AngeloDuenas/Micromouse/Micromouse v2/team3_BOM_micromouse_202526_7F5.xlsx

Price | Qty | Value | Datasheet | Digikey | Reference | Description | Tag
0.10 | 1 | 440054-2 | https://www.te.com/usa-en/product-440054-2.datasheet.pdf | https://www.digikey.com/en/products/detail/te-connectivity-amp-connectors/440054-2/2077939 | J1 | Connector Header Through Hole 2 position 0.079" (2.00mm) | 2
3.56 | 4 | INL-5AMIR15 | https://www.inolux-corp.com/datasheet/IR/Emitter/5mm%20Lamp/INL-5AMIR15_V1.0.pdf | https://www.digikey.com/en/products/detail/inolux/INL-5AMIR15/10384755 | LED1,LED2,LED3,LED4 | Infrared (IR) Emitter 880nm 1.3V 100mA 7.8mW/sr @ 20mA 15° Radial | 2
1.72 | 4 | BS170 | https://www.onsemi.com/pub/Collateral/BS170-D.PDF | https://www.digikey.com/en/products/detail/onsemi/BS170/244280 | Q1,Q2,Q3,Q4 | N-Channel 60 V 500mA (Ta) 830mW (Ta) Through Hole TO-92-3 | 2
3.20 | 4 | SFH 313 FA-3/4 | https://look.ams-osram.com/m/5f84917e436bcd12/original/SFH-313-FA.pdf | https://www.digikey.com/en/products/detail/ams-osram-usa-inc/SFH-313-FA-3-4/1630112 | Q5,Q6,Q7,Q8 | Phototransistors 870nm Top View Radial | 2
0.72 | 1 | EG1218 | https://configured-product-images.s3.amazonaws.com/Datasheets/EG.pdf | https://www.digikey.com/en/products/detail/e-switch/EG1218/101726 | SW1 | Slide Switch SPDT Through Hole | 2
0.57 | 1 | LD1117V33 | https://www.st.com/content/ccc/resource/technical/document/datasheet/99/3b/7d/91/91/51/4b/be/CD00000544.pdf/files/CD00000544.pdf/jcr:content/translations/en.C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 | https://www.digikey.com/en/products/detail/stmicroelectronics/LD1117V33/586012 | U1 | Linear Voltage Regulator IC Positive Fixed 1 Output 800mA TO-220 | 2
8.86 | 1 | L293D | https://www.st.com/content/ccc/resource/technical/document/datasheet/04/ac/22/f9/20/5d/43/a1/CD00000059.pdf/files/CD00000059.pdf/jcr:content/translations/en.C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 | https://www.digikey.com/en/products/detail/stmicroelectronics/L293D/634700 | U2 | Bipolar Motor Driver Parallel 16-PowerDIP | 2
1.74 | 2 | BM06B-SRSS-TBT | https://www.jst-mfg.com/product/pdf/eng/eSR_SZ.pdf | https://www.digikey.com/en/products/detail/jst-sales-america-inc/bm06b-srss-tbt/1785724 | J3,J4 | Connector Header Surface Mount 6 position 0.039" (1.00mm) | 0
7.18 | 2 | PinSocket_2x19_P2.54mm_Vertical | https://www.pololu.com/product/3676/specs | https://www.pololu.com/product/3676 | J5,J6 | Stackable 0.100″ Female Header for TI-RSLK MAX: 2x19-Pin, Straight | 0
9.50 | 2 | PinSocket_2x20_P2.54mm_Vertical | https://www.pololu.com/product/2748/specs | https://www.pololu.com/product/2748 | ~ | This stackable 40-pin female header features two rows of 20 pins spaced with a 0.1″ (2.54 mm) pitch. The extended pins allow multiple units to be stacked as popularized on Arduino shields. The 2×20 size is notably used on the Raspberry Pi Models A+ and B+ as well as the Raspberry Pi 2 Model B. | 0
0.79 | 1 | PinHeader_1x04_P2.54mm_Vertical_SMD_Pin1Left | https://www.pololu.com/product/1014/specs | https://www.pololu.com/product/1014 | J7 | 0.100" (2.54 mm) Female Header: 1x4-Pin, Straight | 0
59.90 | 2 | 30:1 Micro Metal Gearmotor MP 6V with 12 CPR Encoder, Back Connector | https://www.pololu.com/file/0J1487/pololu-micro-metal-gearmotors-rev-6-1.pdf | https://www.pololu.com/product/5132 | ~ | MP 6V: medium-power 6V with precious metal brushes, 9.86:1 with brass plates , 6 V , 720 RPM, 70 mA | 3
2.95 | 1 | Pololu Micro Metal Gearmotor Bracket Pair – White | https://www.pololu.com/product/1086/specs | https://www.pololu.com/product/1086 | ~ | These plastic mounting brackets allow you to easily and securely mount the ubiquitous 10 mm × 12 mm × 26 mm metal gearhead motors first popularized by Sanyo’s 12GN series (e.g. NA1S…NA3S), such as our micro metal gearmotors. We offer these brackets in black plastic and white plastic, and we offer an extended version that might work better for particular applications. | 3
4.45 | 1 | Pololu Wheel 32×7mm Pair - White | https://www.pololu.com/product/1088/specs | https://www.pololu.com/product/1088/ | ~ | These white plastic wheels have silicone tires and measure 32 mm (1.26″) in diameter. They press-fit onto the 3mm D shafts on many of our motors, including our micro metal gearmotors and our mini plastic gearmotors, to make a nice drive solution for small robots. They are sold in pairs. | 3
7.22 | 2 | JST SH-Style Cable, 6-Pin, Female-Female, 16cm | https://www.pololu.com/product/5544/specs | https://www.pololu.com/product/5544 | ~ | This 6-conductor, 16 cm (6.3″) cable has 28 AWG wires and 6-pin female JST SH-type connectors (1mm pitch) on both ends. | 3
13.82 | 1 | NUCLEO-F411RE | https://www.st.com/content/ccc/resource/technical/document/data_brief/c8/3c/30/f7/d6/08/4a/26/DM00105918.pdf/files/DM00105918.pdf/jcr:content/translations/en.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 | https://www.digikey.com/en/products/detail/stmicroelectronics/NUCLEO-F411RE/4866485 | ~ | STM32F411RE Nucleo-64 STM32F4 ARM® Cortex®-M4 MCU 32-Bit Embedded Evaluation Board | 1
0.00 | 4 | 47KΩ | ~ | ~ | R2,R6,R9,R12 | 47KΩ±1% 1/4W Metal Film Resistor Axial | 0
0.00 | 4 | 51Ω | ~ | ~ | R3,R7,R10,R13 | 51Ω±1% 1/4W Metal Film Resistor Axial | 0
0.00 | 4 | 100Ω | ~ | ~ | R1,R5,R8,R11 | 100Ω±1% 1/4W Metal Film Resistor Axial | 0
0.00 | 4 | 1.8KΩ | ~ | ~ | R4,R14,R15,R16 | 1.8KΩ±1% 1/4W Metal Film Resistor Axial | 0
0.00 | 3 | 0.1uF | ~ | ~ | C1,C5,C8 | 0.1µF ±10% 50V Multilayer Ceramic Capacitor Radial | 0
0.00 | 1 | 1uF | ~ | ~ | C9 | 1.0µF ±10% 50V Multilayer Ceramic Capacitor Radial | 0
0.00 | 3 | 4.7uF | ~ | ~ | C4,C6,C7 | 4.7µF ±10% 25V Multilayer Ceramic Capacitor Radial | 0
0.00 | 2 | 10uF | ~ | ~ | C2,C3 | 10µF ±10% 25V Multilayer Ceramic Capacitor Radial | 0
0.00 | 1 | Battery | ~ | ~ | ~ | ~ | 1
126.28 | 56 | Budget | ~ | ~ | ~ | Team 3 Micromouse 2026 Budget | -1
