AngeloDuenas/Micromouse/Micromouse v2/imports/CF18JT680R.STEP

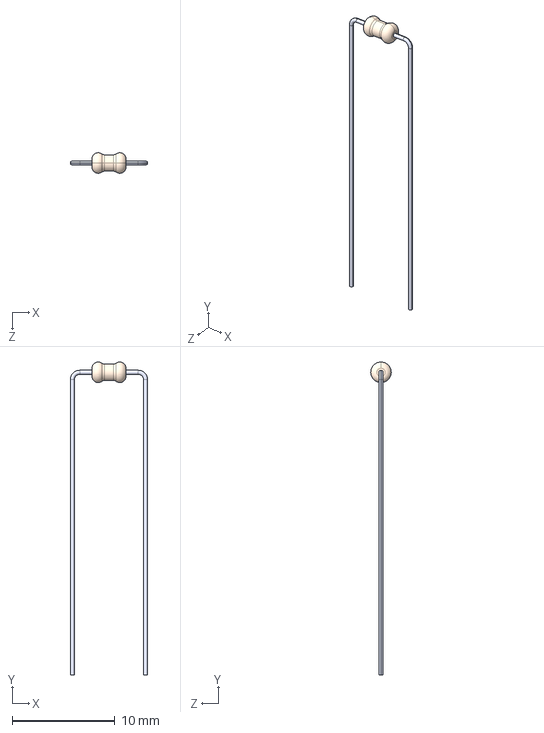
[picture p1: CAD file, 2026-10-30]
Micromouse v2/imports/CF18JT680R.STEP
7.52 x 30.4 x 2.00 mm
