AngeloDuenas/Micromouse/Micromouse v2/imports/ul_BM06B-SRSS-TB-LF-SN-/BM06B-SRSS-TBT--3DModel-STEP-56544.STEP

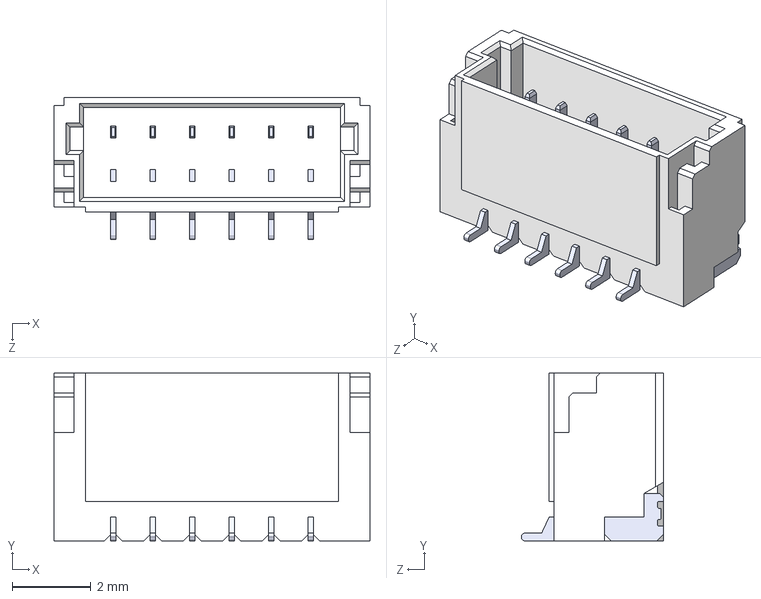
[picture p2: CAD file, 2026-10-30]
Micromouse v2/imports/ul_BM06B-SRSS-TB-LF-SN-/BM06B-SRSS-TBT--3DModel-STEP-56544.STEP
8.00 x 4.25 x 3.60 mm
