AngeloDuenas/Micromouse/Micromouse v2/imports/ul_INL-5AMIR15/Download_STP_WL-TIRW-5mm+%28rev1%29.stp

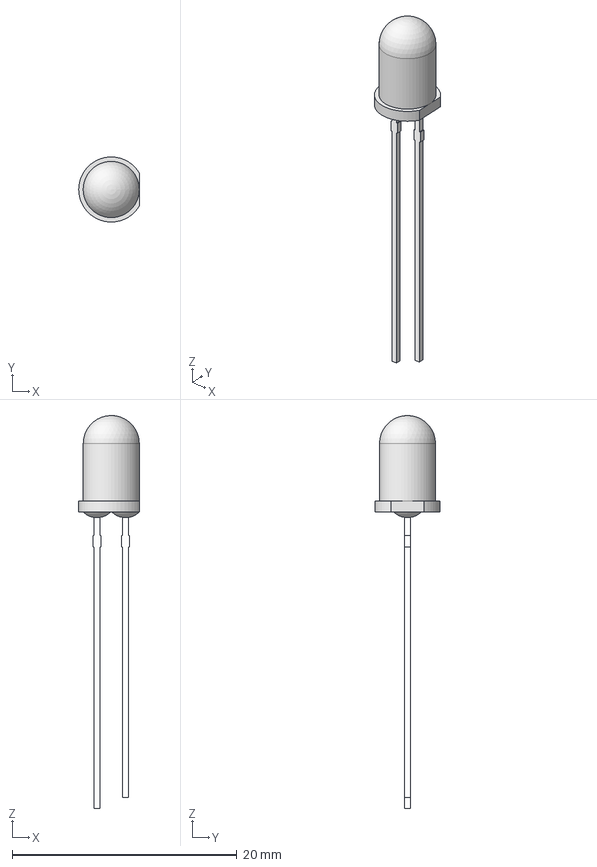
[picture p3: CAD file, 2026-10-30]
Micromouse v2/imports/ul_INL-5AMIR15/Download_STP_WL-TIRW-5mm+%28rev1%29.stp
5.40 x 5.79 x 35.0 mm
