AngeloDuenas/Micromouse/Micromouse v2/imports/ul_SFH-313-FA-3-4/SFH 313FA.STEP

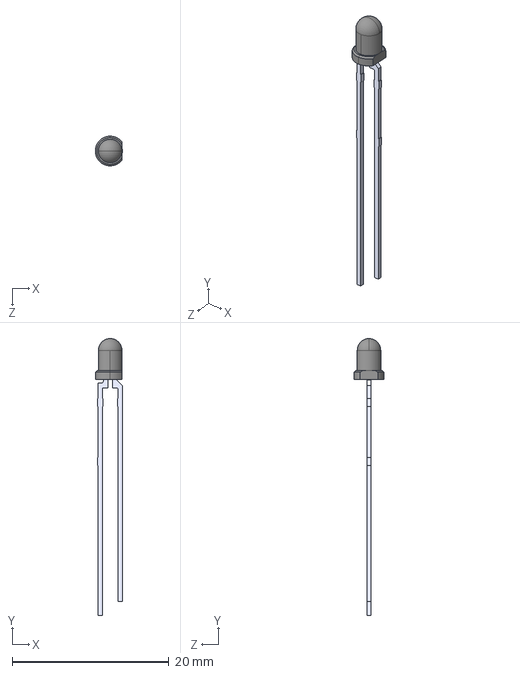
[picture p4: CAD file, 2026-10-30]
Micromouse v2/imports/ul_SFH-313-FA-3-4/SFH 313FA.STEP
3.50 x 35.3 x 3.80 mm
