AngeloDuenas/Micromouse/Micromouse v2/team3_micromouse_display_pdfdark.pdf

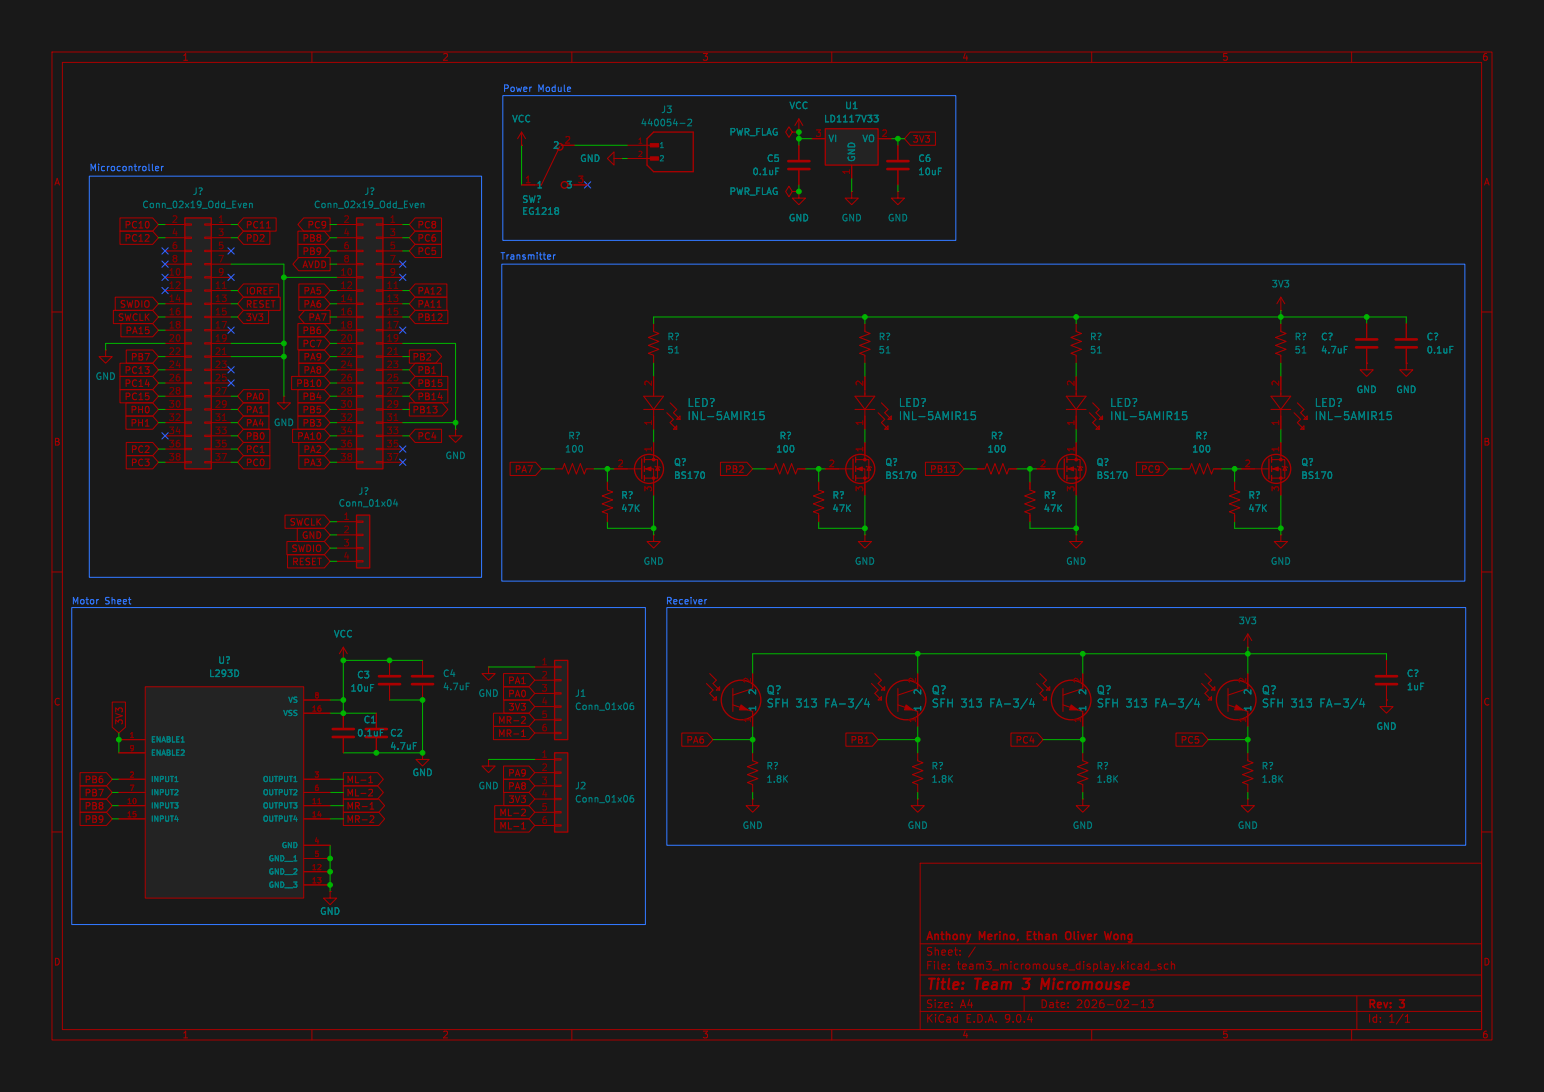
[picture p5: page 1]

Id: 1/1 Title: Team 3 Micromouse
