AngeloDuenas/Micromouse/Micromouse v2/team3_micromouse_202526_7F5.kicad_pcb

## KiCad design Micromouse v2/team3_micromouse_202526_7F5.kicad_pcb (2026-10-30)

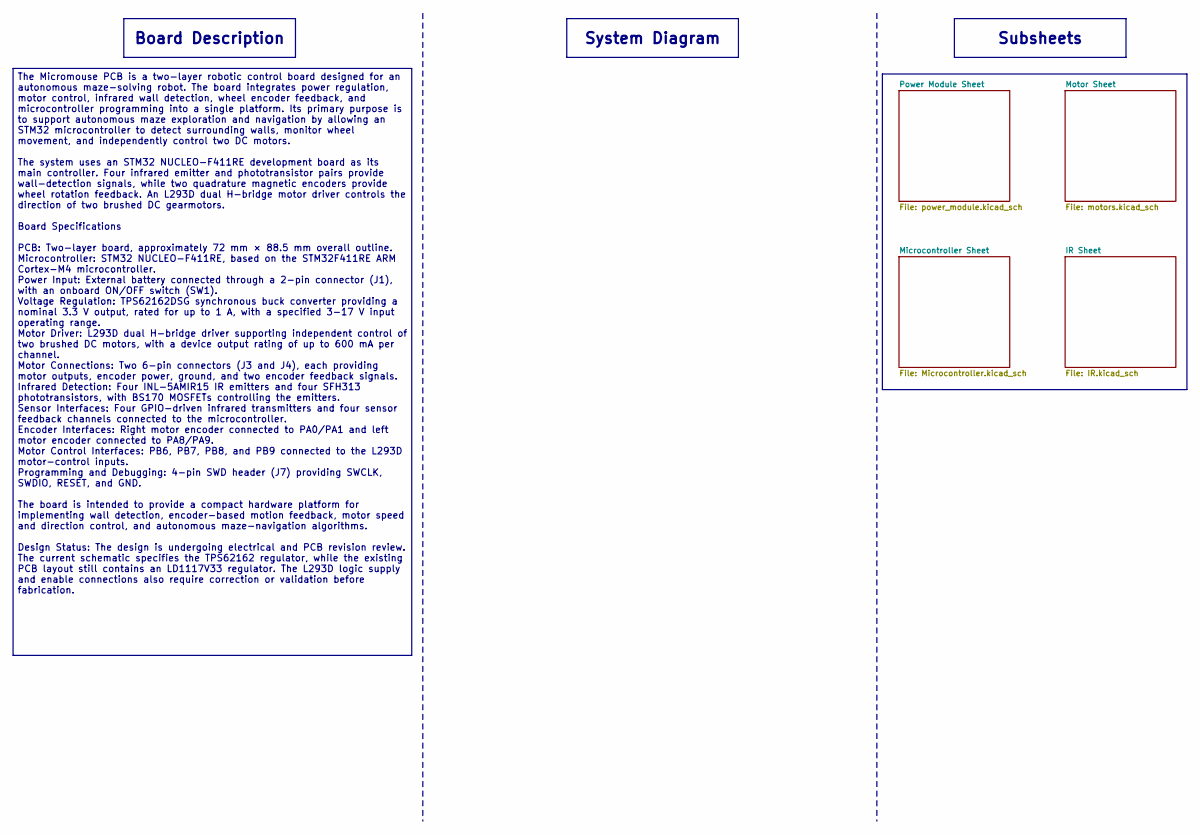
[picture p7: schematic team3_micromouse_202526_7F5.kicad_sch]

Notes on the sheet:
System Diagram
Board Description
The Micromouse PCB is a two-layer robotic control board designed for an autonomous maze-solving robot. The board integrates power regulation, motor control, infrared wall detection, wheel encoder feedback, and microcontroller programming into a single platform. Its primary purpose is to support aut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
Subsheets

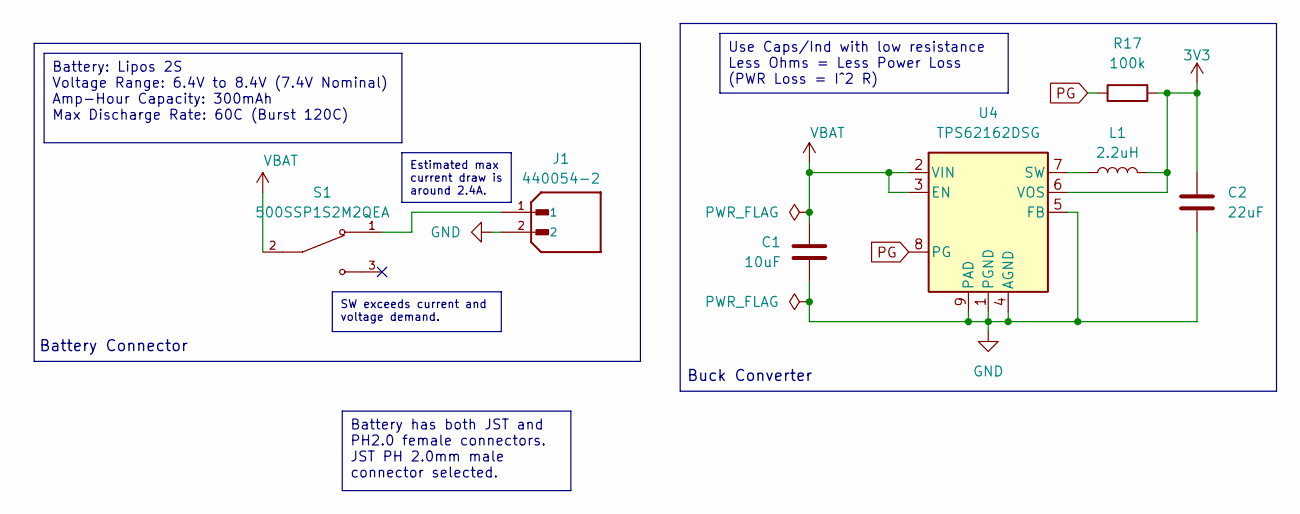
[picture p8: schematic power_module.kicad_sch, Team 3 Micromouse]

Parts:
C1: 10uF; CAP_C320_KEM
C2: 22uF; CAP_C320_KEM
J1: 440054-2; TE_440054-2_1x02_P2.00mm_Vertical; PARTREV F9
L1: 2.2uH; L_0603_1608Metric
R17: 100k; R_0603_1608Metric
S1: 500SSP1S2M2QEA; SW_500SSP1S2M2QEA; PARTREV C
U4: TPS62162DSG; WSON-8-1EP_2x2mm_P0.5mm_EP0.9x1.6mm_ThermalVias

Connections:
3V3: C2.1, L1.2, R17.2, U4.6 (VOS); also elsewhere on the board
GND: C1.2, C2.2, J1.2, U4.1 (PGND), U4.4 (AGND), U4.5 (FB), U4.9 (PAD); also elsewhere on the board
unnamed: J1.1, S1.1
unnamed: L1.1, U4.7 (SW)
PG: R17.1, U4.8 (PG)
VBAT: C1.1, S1.2, U4.2 (VIN), U4.3 (EN); also elsewhere on the board

Notes on the sheet:
Battery Connector
Buck Converter
Estimated max current draw is around 2.4A.
Use Caps/Ind with low resistance Less Ohms = Less Power Loss (PWR Loss = I^2 R)
Battery has both JST and PH2.0 female connectors. JST PH 2.0mm male connector selected.
SW exceeds current and voltage demand.
Battery: Lipos 2S Voltage Range: 6.4V to 8.4V (7.4V Nominal) Amp-Hour Capacity: 300mAh Max Discharge Rate: 60C (Burst 120C)

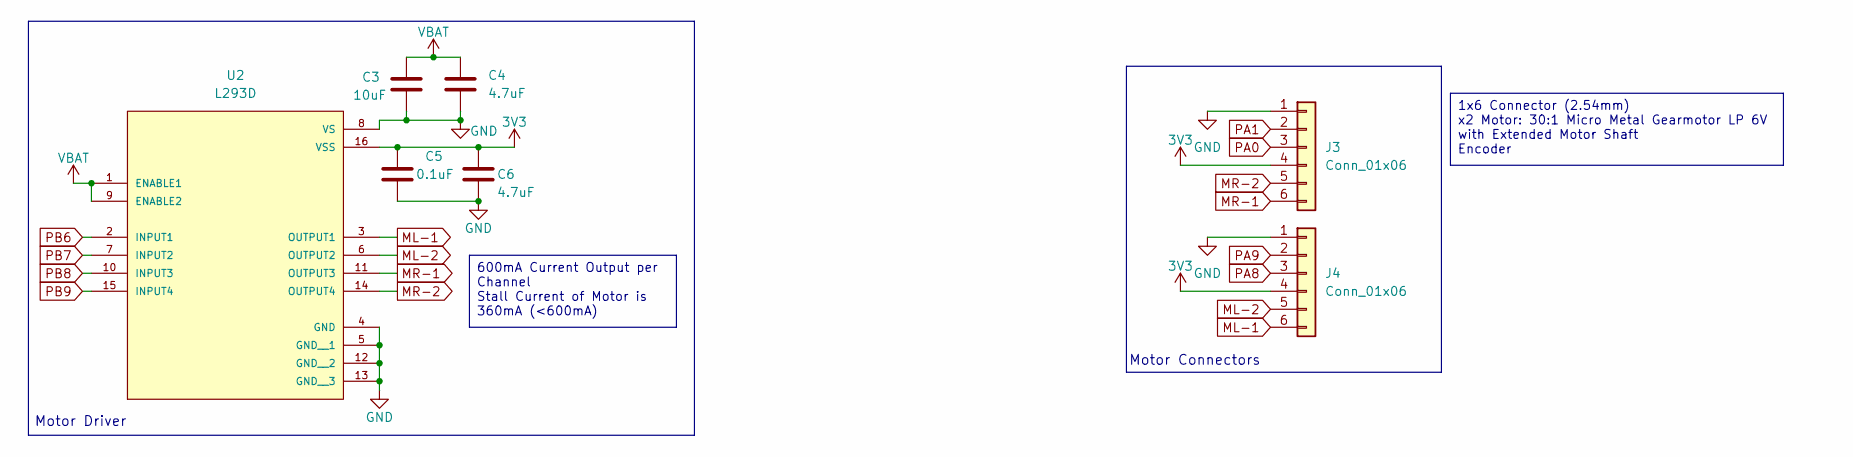
[picture p9: schematic motors.kicad_sch, Team 3 Micromouse]

Parts:
C3: 10uF; CAP_C320_KEM
C4, C6: 4.7uF; CAP_C320_KEM
C5: 0.1uF; CAP_C320_KEM
J3, J4: Conn_01x06; PinHeader_1x06_P2.54mm_Vertical
U2: L293D; DIP880W50P254L2000H510Q16

Connections:
3V3: C5.1, C6.1, J3.4, J4.4, U2.16 (VSS); also elsewhere on the board
GND: C3.2, C4.2, C5.2, C6.2, J3.1, J4.1, U2.4 (GND), U2.5 (GND__1), U2.8 (VS), U2.12 (GND__2), U2.13 (GND__3); also elsewhere on the board
ML-1: J4.6, U2.3 (OUTPUT1)
ML-2: J4.5, U2.6 (OUTPUT2)
MR-1: J3.6, U2.11 (OUTPUT3)
MR-2: J3.5, U2.14 (OUTPUT4)
PA0: J3.3; also elsewhere on the board
PA1: J3.2; also elsewhere on the board
PA8: J4.3; also elsewhere on the board
PA9: J4.2; also elsewhere on the board
PB6: U2.2 (INPUT1); also elsewhere on the board
PB7: U2.7 (INPUT2); also elsewhere on the board
PB8: U2.10 (INPUT3); also elsewhere on the board
PB9: U2.15 (INPUT4); also elsewhere on the board
VBAT: C3.1, C4.1, U2.1 (ENABLE1), U2.9 (ENABLE2); also elsewhere on the board

Notes on the sheet:
Motor Connectors
Motor Driver
1x6 Connector (2.54mm) x2 Motor: 30:1 Micro Metal Gearmotor LP 6V with Extended Motor Shaft Encoder
600mA Current Output per Channel Stall Current of Motor is 360mA (<600mA)

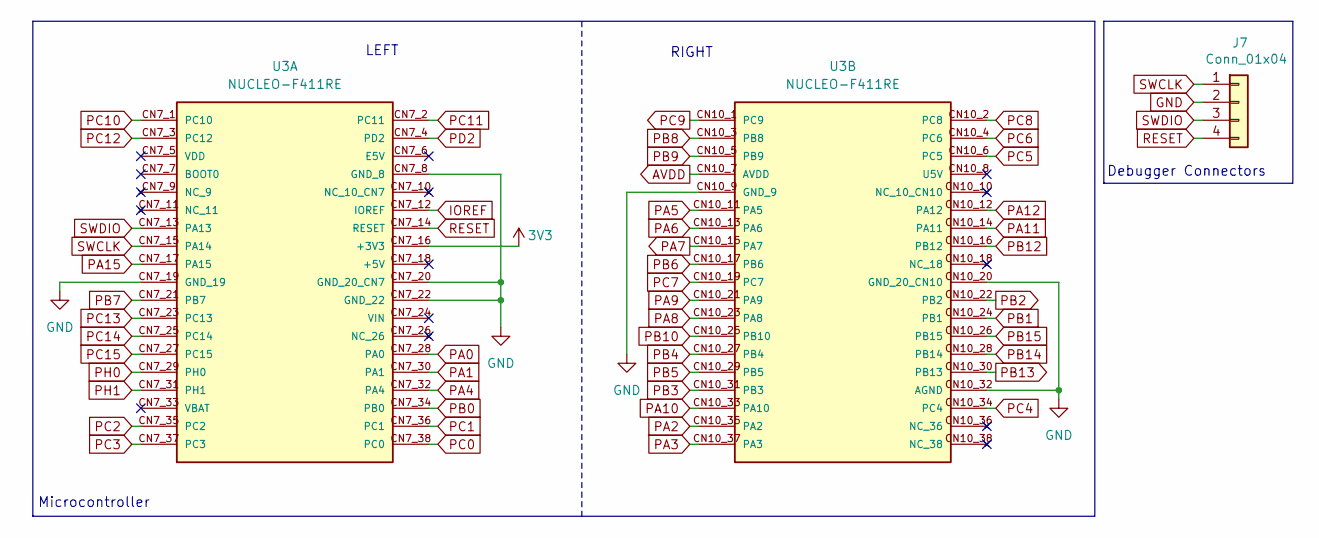
[picture p10: schematic Microcontroller.kicad_sch, Team 3 Micromouse]

Parts:
J7: Conn_01x04; PinSocket_1x04_P2.54mm_Vertical
U3: NUCLEO-F411RE; PARTREV 14; DigiKey_Part_Number 497-14711-ND

Connections:
3V3: U3.CN7_16 (+3V3); also elsewhere on the board
AVDD: U3.CN10_7 (AVDD)
GND: J7.2, U3.CN7_8 (GND_8), U3.CN7_19 (GND_19), U3.CN7_20 (GND_20_CN7), U3.CN7_22 (GND_22), U3.CN10_9 (GND_9), U3.CN10_20 (GND_20_CN10), U3.CN10_32 (AGND); also elsewhere on the board
IOREF: U3.CN7_12 (IOREF)
PA0: U3.CN7_28 (PA0); also elsewhere on the board
PA1: U3.CN7_30 (PA1); also elsewhere on the board
PA2: U3.CN10_35 (PA2)
PA3: U3.CN10_37 (PA3)
PA4: U3.CN7_32 (PA4)
PA5: U3.CN10_11 (PA5)
PA6: U3.CN10_13 (PA6); also elsewhere on the board
PA7: U3.CN10_15 (PA7); also elsewhere on the board
PA8: U3.CN10_23 (PA8); also elsewhere on the board
PA9: U3.CN10_21 (PA9); also elsewhere on the board
PA10: U3.CN10_33 (PA10)
PA11: U3.CN10_14 (PA11)
PA12: U3.CN10_12 (PA12)
PA15: U3.CN7_17 (PA15)
PB0: U3.CN7_34 (PB0)
PB1: U3.CN10_24 (PB1); also elsewhere on the board
PB2: U3.CN10_22 (PB2); also elsewhere on the board
PB3: U3.CN10_31 (PB3)
PB4: U3.CN10_27 (PB4)
PB5: U3.CN10_29 (PB5)
PB6: U3.CN10_17 (PB6); also elsewhere on the board
PB7: U3.CN7_21 (PB7); also elsewhere on the board
PB8: U3.CN10_3 (PB8); also elsewhere on the board
PB9: U3.CN10_5 (PB9); also elsewhere on the board
PB10: U3.CN10_25 (PB10)
PB12: U3.CN10_16 (PB12)
PB13: U3.CN10_30 (PB13); also elsewhere on the board
PB14: U3.CN10_28 (PB14)
PB15: U3.CN10_26 (PB15)
PC0: U3.CN7_38 (PC0)
PC1: U3.CN7_36 (PC1)
PC2: U3.CN7_35 (PC2)
PC3: U3.CN7_37 (PC3)
PC4: U3.CN10_34 (PC4); also elsewhere on the board
PC5: U3.CN10_6 (PC5); also elsewhere on the board
PC6: U3.CN10_4 (PC6)
PC7: U3.CN10_19 (PC7)
PC8: U3.CN10_2 (PC8)
PC9: U3.CN10_1 (PC9); also elsewhere on the board
PC10: U3.CN7_1 (PC10)
PC11: U3.CN7_2 (PC11)
PC12: U3.CN7_3 (PC12)
PC13: U3.CN7_23 (PC13)
PC14: U3.CN7_25 (PC14)
PC15: U3.CN7_27 (PC15)
PD2: U3.CN7_4 (PD2)
PH0: U3.CN7_29 (PH0)
PH1: U3.CN7_31 (PH1)
RESET: J7.4, U3.CN7_14 (RESET)
SWCLK: J7.1, U3.CN7_15 (PA14)
SWDIO: J7.3, U3.CN7_13 (PA13)

Notes on the sheet:
Debugger Connectors
Microcontroller
RIGHT
LEFT

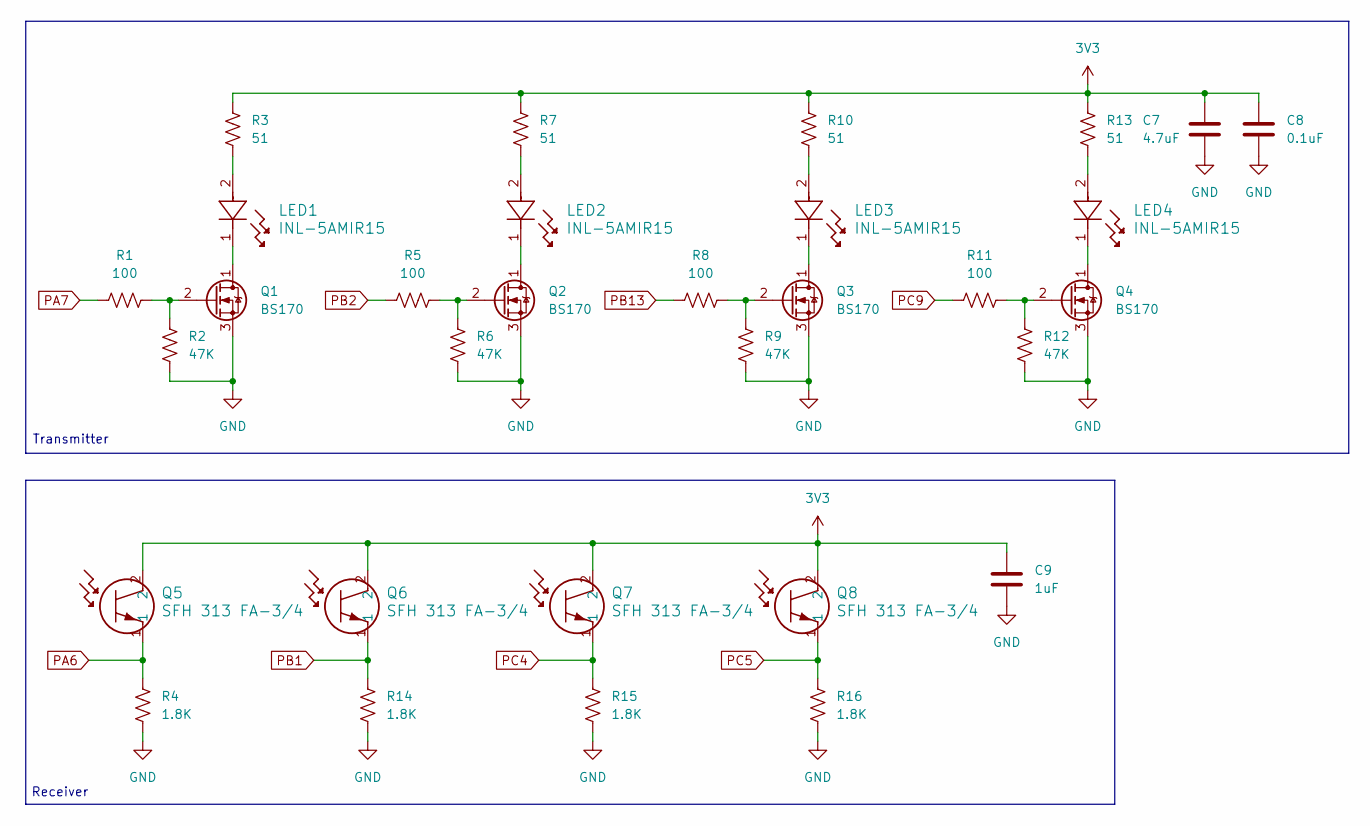
[picture p11: schematic IR.kicad_sch, Team 3 Micromouse]

Parts:
C7: 4.7uF; CAP_C320_KEM
C8: 0.1uF; CAP_C320_KEM
C9: 1uF; CAP_C320_KEM
LED1, LED2, LED3, LED4: INL-5AMIR15; LED_INL-5AMIR15_INO
Q1, Q2, Q3, Q4: BS170; TO-92_Inline
Q5, Q6, Q7, Q8: SFH 313 FA-3/4; SFH 313 FA-3&slash_4_OSR
R1, R5, R8, R11: 100; R_Axial_DIN0204_L3.6mm_D1.6mm_P1.90mm_Vertical
R2, R6, R9, R12: 47K; R_Axial_DIN0204_L3.6mm_D1.6mm_P1.90mm_Vertical
R3, R7, R10, R13: 51; R_Axial_DIN0204_L3.6mm_D1.6mm_P1.90mm_Vertical
R4, R14, R15, R16: 1.8K; R_Axial_DIN0204_L3.6mm_D1.6mm_P1.90mm_Vertical

Connections:
3V3: C7.1, C8.1, C9.1, Q5.2, Q6.2, Q7.2, Q8.2, R3.2, R7.2, R10.2, R13.2; also elsewhere on the board
GND: C7.2, C8.2, C9.2, Q1.3 (S), Q2.3 (S), Q3.3 (S), Q4.3 (S), R2.1, R4.1, R6.1, R9.1, R12.1, R14.1, R15.1, R16.1; also elsewhere on the board
unnamed: LED1.2, R3.1
unnamed: LED2.2, R7.1
unnamed: LED3.2, R10.1
unnamed: LED4.2, R13.1
unnamed: LED1.1, Q1.1 (D)
unnamed: Q1.2 (G), R1.2, R2.2
unnamed: LED2.1, Q2.1 (D)
unnamed: Q2.2 (G), R5.2, R6.2
unnamed: LED3.1, Q3.1 (D)
unnamed: Q3.2 (G), R8.2, R9.2
unnamed: LED4.1, Q4.1 (D)
unnamed: Q4.2 (G), R11.2, R12.2
PA6: Q5.1, R4.2; also elsewhere on the board
PA7: R1.1; also elsewhere on the board
PB1: Q6.1, R14.2; also elsewhere on the board
PB2: R5.1; also elsewhere on the board
PB13: R8.1; also elsewhere on the board
PC4: Q7.1, R15.2; also elsewhere on the board
PC5: Q8.1, R16.2; also elsewhere on the board
PC9: R11.1; also elsewhere on the board

Notes on the sheet:
Transmitter
Receiver

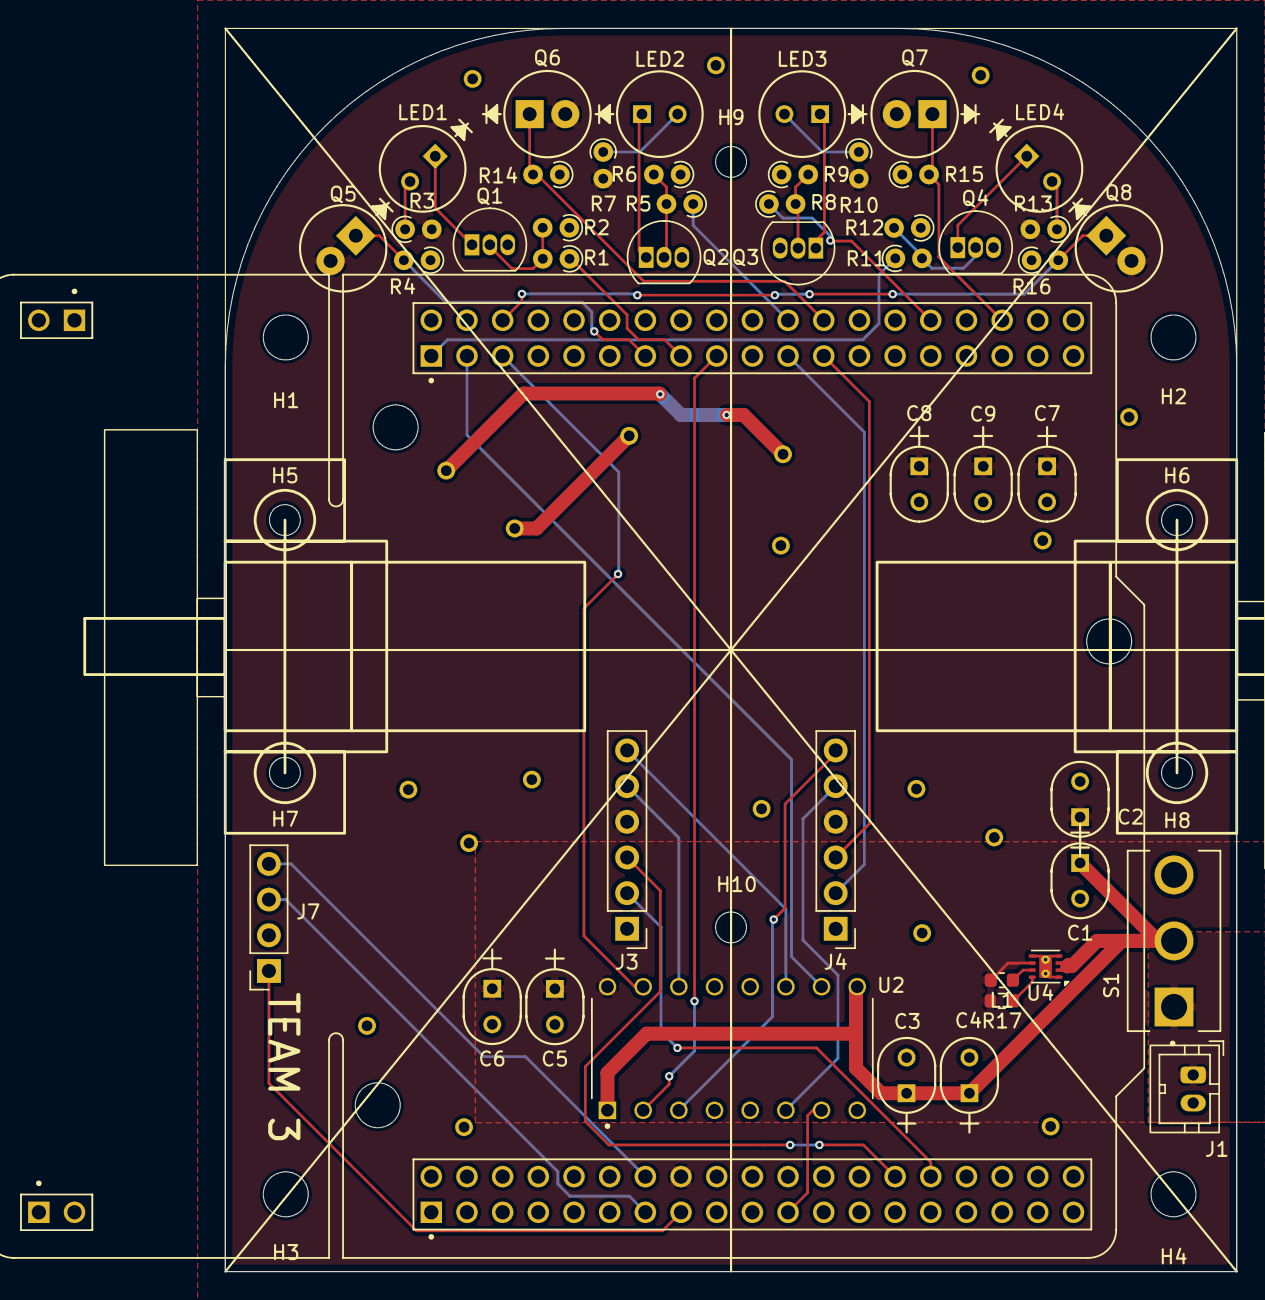
[picture p12: board team3_micromouse_202526_7F5.kicad_pcb from above]

Board: 2 copper layers, 72.0 x 88.5 mm, 57 parts (0 on the bottom side), 41 nets.

Other parts of the board:
H1, H2, H3, H4: MountingHole_3.2mm_M3
H5, H6, H7, H8: MountingHole_2.2mm_#2-56; MountingHole_2.2mm_M2
H9, H10: MountingHole_2.2mm_M2
